nathanpaulscott/gas_meter/images/thumbnail.png

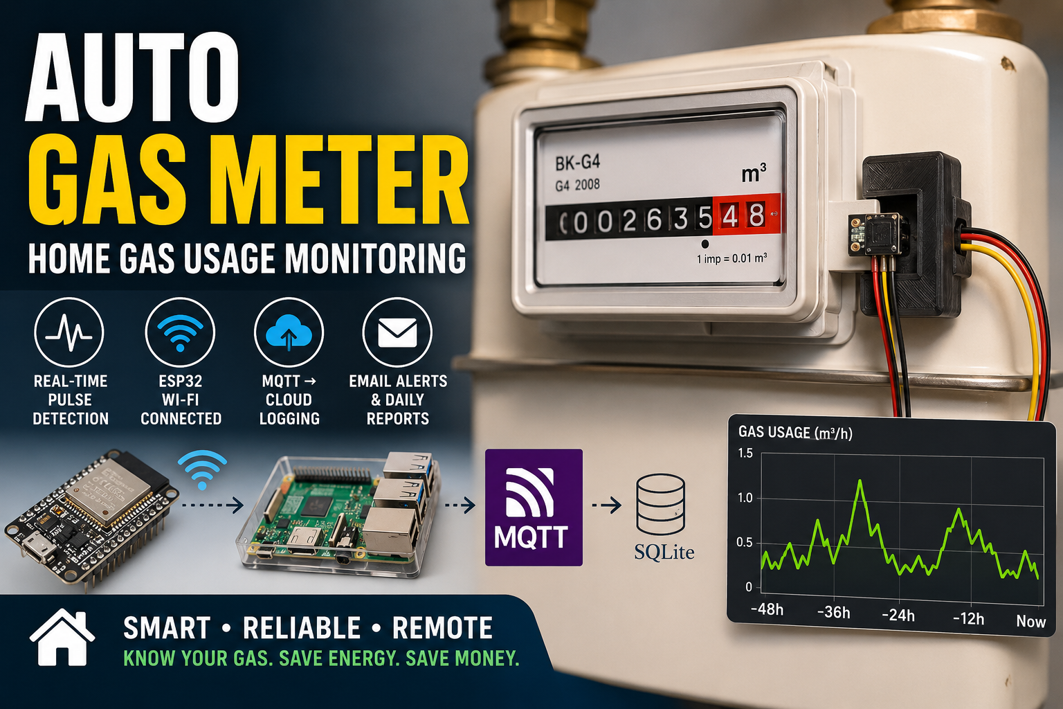
images/thumbnail.png
