nathanpaulscott/gas_meter/u-controller and RF comms/esp32 wifi unit.jpg

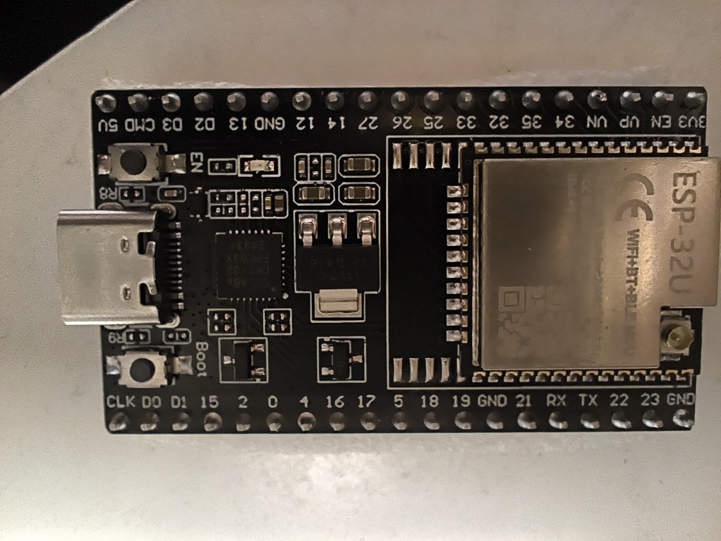
u-controller and RF comms/esp32 wifi unit.jpg
