nathanpaulscott/gas_meter/magnetic sensors/using this one/readme.txt

i ordered more as the sensors are sensitive and can break easy during soldering.

So what you need is a little bit of perfboard with tabs with 3 channels and say 4 holes per ch

the  sensor front is the bevelled side, this is also teh side of best magnetic sensitivity, so it faces the magnet later

looking at the sensor from teh beveled side, vcc is left, gnd is centre and vout is right
you need a 100nf cap between vcc and gnd
