nathanpaulscott/gas_meter/images/gas_plot_rate.png

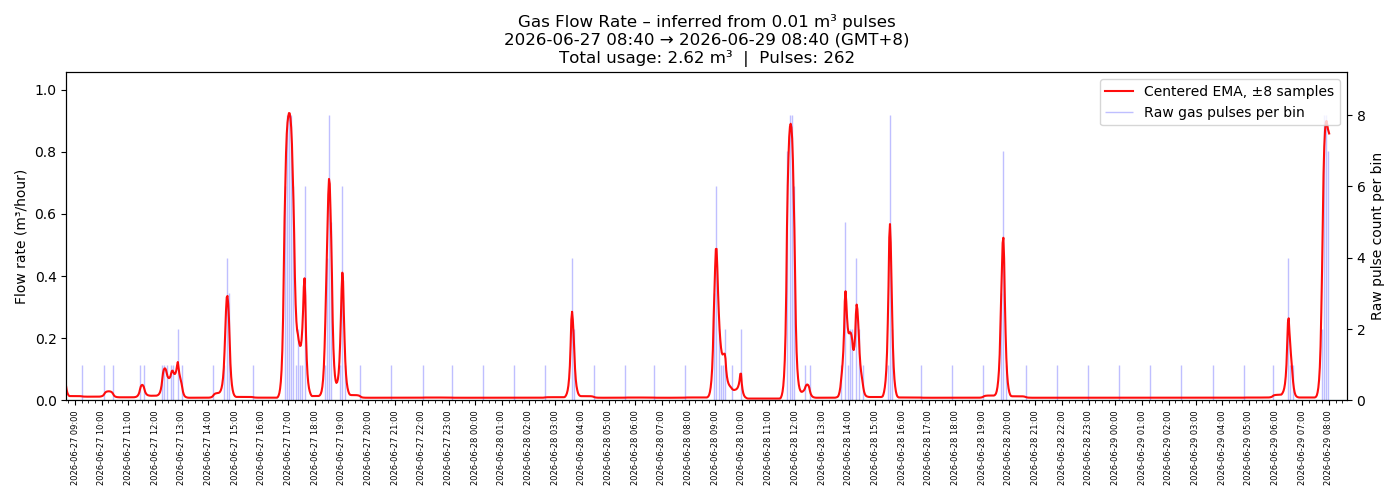
images/gas_plot_rate.png
