nathanpaulscott/gas_meter/u-controller and RF comms/docs/board pin layout - VIP.png

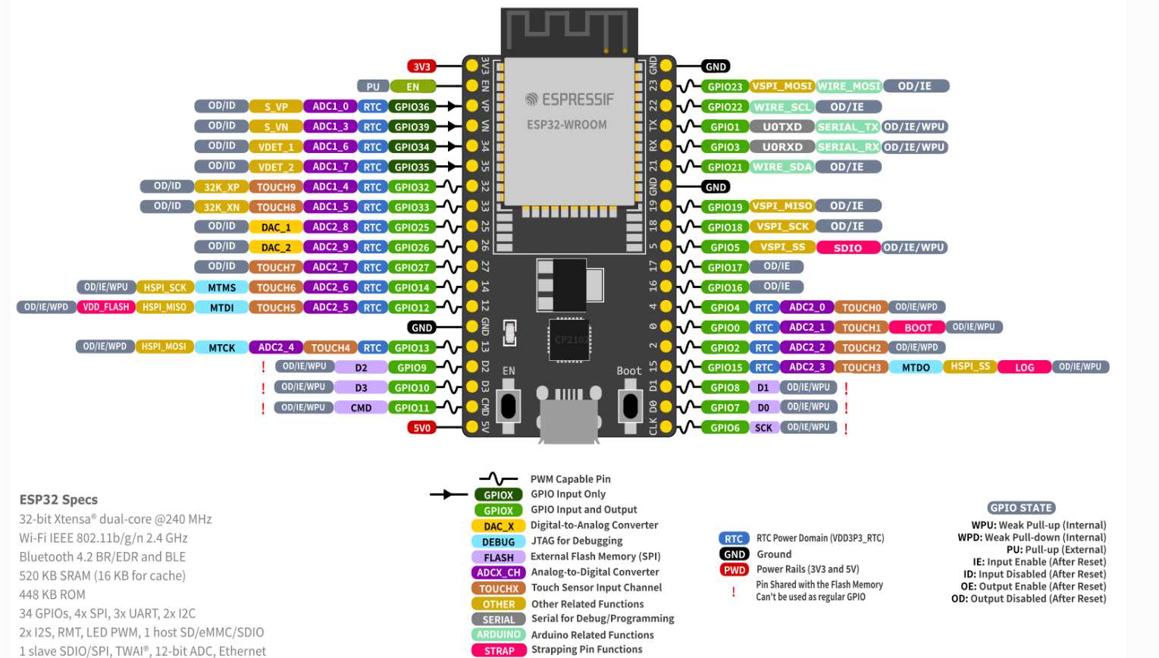
u-controller and RF comms/docs/board pin layout - VIP.png
