nathanpaulscott/gas_meter/(commit log)

2026-06-25 added sample plot
2026-06-26 modified sample image
